imenbenadda/digitalprototypeproject_exsu620/docs/final_rig.jpg

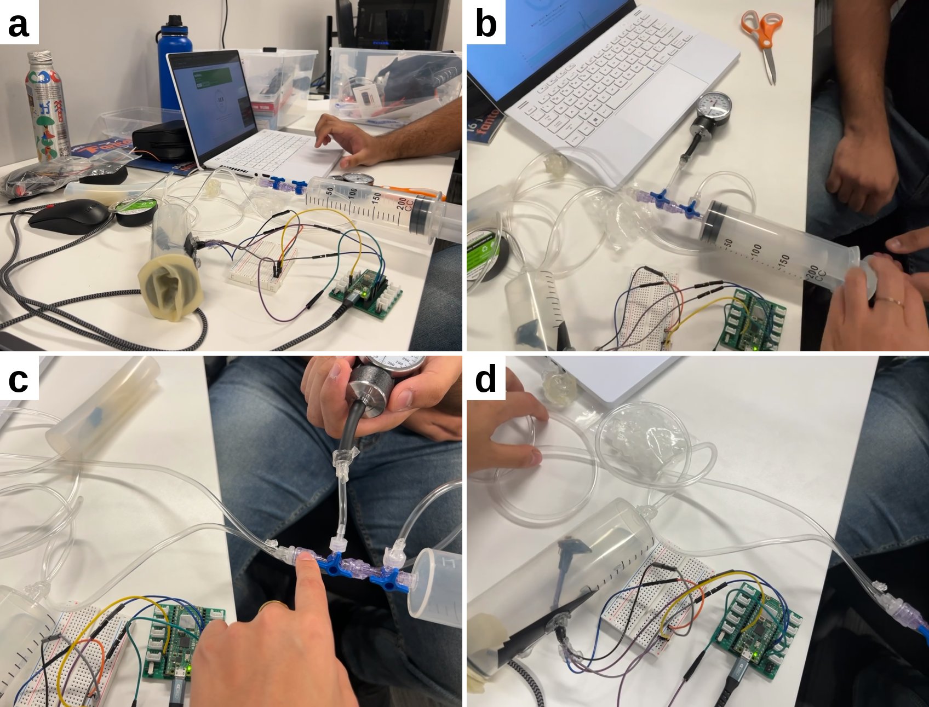
docs/final_rig.jpg
