imenbenadda/digitalprototypeproject_exsu620/docs/dashboard_sms_signup.png

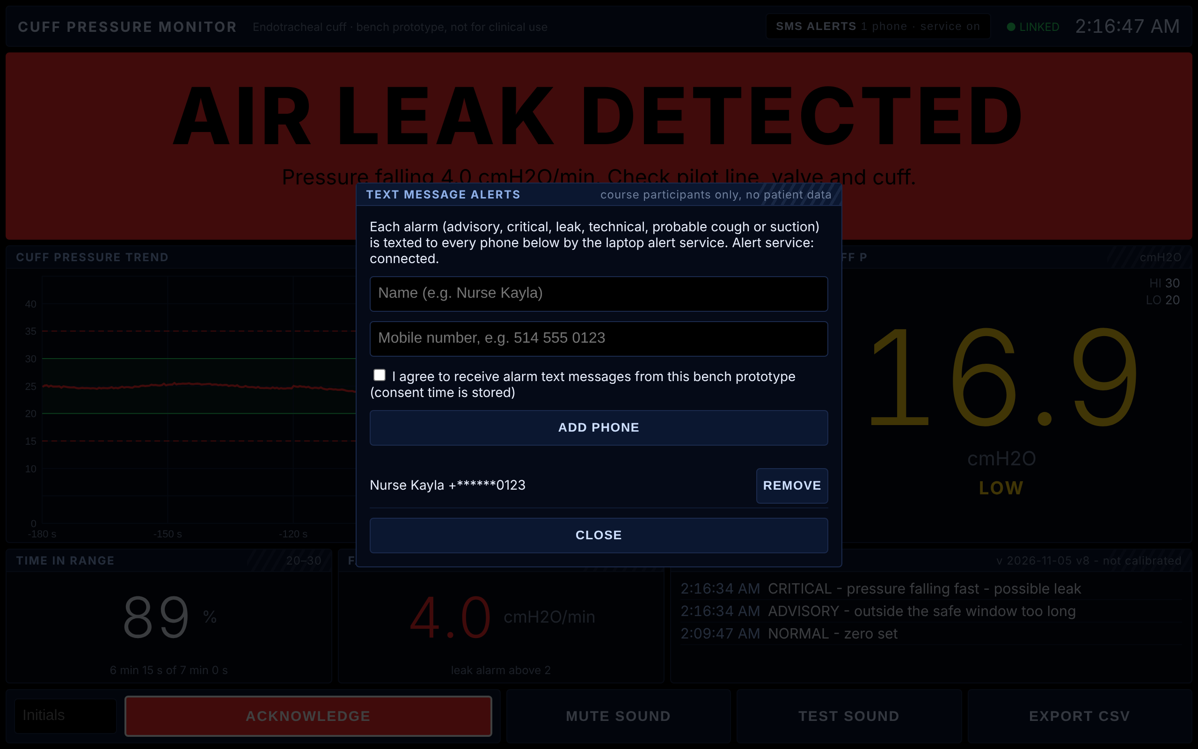
docs/dashboard_sms_signup.png
