imenbenadda/digitalprototypeproject_exsu620/docs/dashboard_states.png

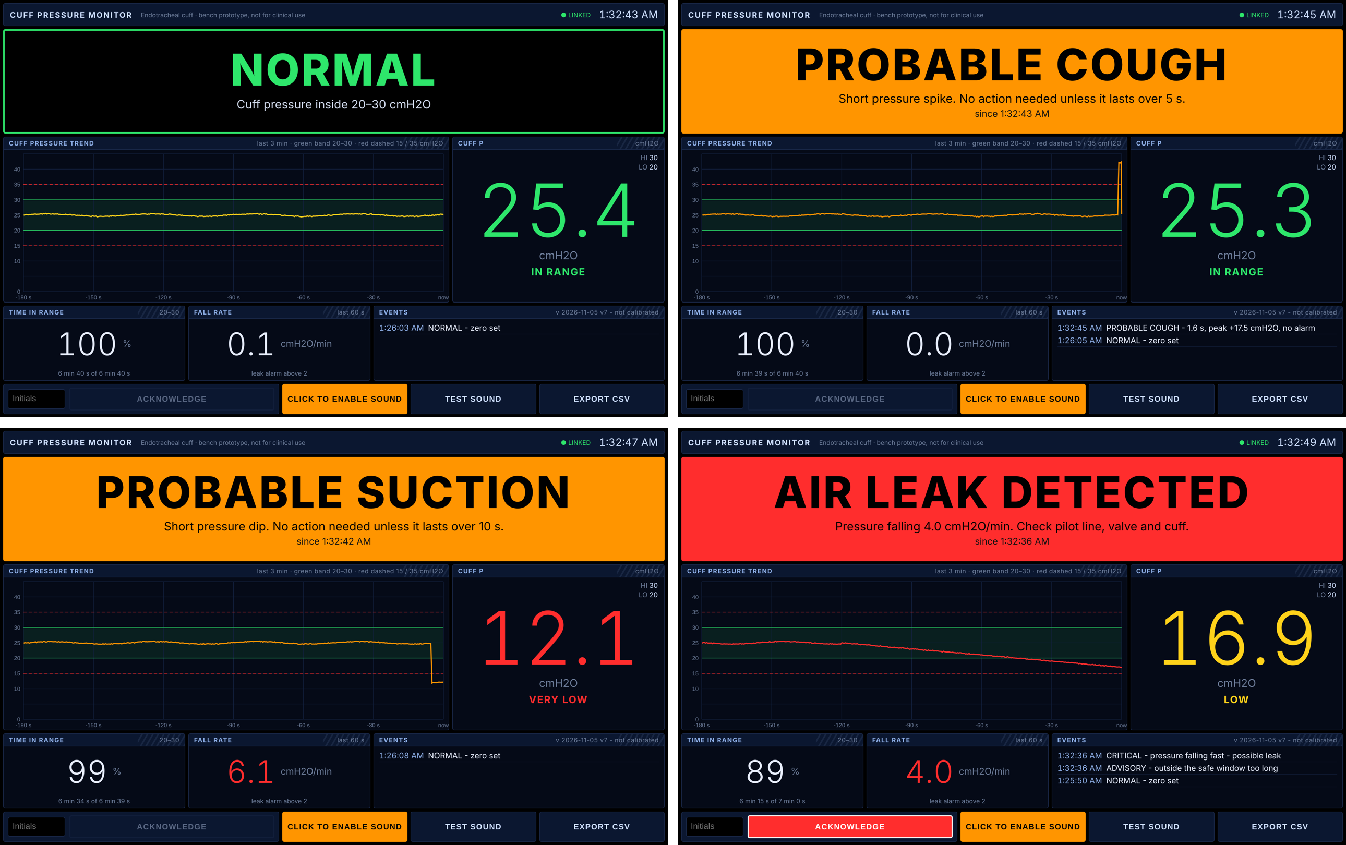
docs/dashboard_states.png
