imenbenadda/digitalprototypeproject_exsu620/cad/cuff_rig_clip.stl

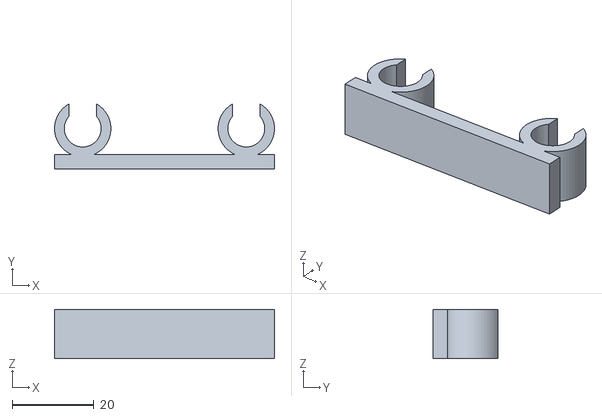
[picture p13: CAD file, 2026-11-05]
cad/cuff_rig_clip.stl
53.8 x 15.9 x 12.0
