imenbenadda/digitalprototypeproject_exsu620/cad/cuff_rig_tray.stl

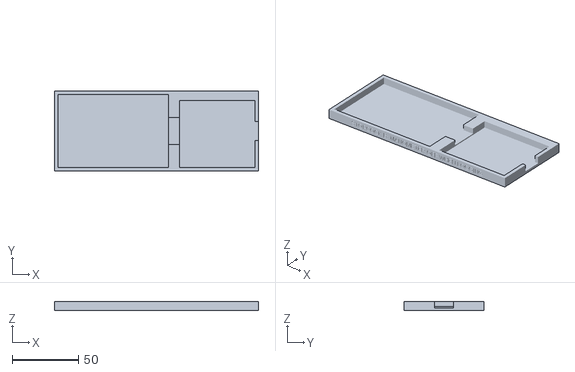
[picture p14: CAD file, 2026-11-05]
cad/cuff_rig_tray.stl
153.5 x 60.5 x 7.00
