imenbenadda/digitalprototypeproject_exsu620/CHANGELOG.md

# Changelog

## 2026-10-22
- Added `cuff_pressure.py`: reads the BMP280 on the Pico 2 W (MicroPython or CircuitPython, no libraries), zeroes to room air, prints cmH2O for Thonny's Plotter with 20/30 cmH2O target lines, warns above 80, saves each trial as CSV on the Pico. Auto-finds the sensor on any Grove I2C port.
- Added `Pico_BMP280_Setup.md`: wiring (Grove shield → BMP280), Thonny/firmware setup, how to run.
- Note: hardware is a Raspberry Pi Pico 2 W on a Grove shield, not a full Raspberry Pi, so the plan's "Pin 1/3/5/6" and "enable I2C" steps don't apply.
- `Pico_BMP280_Setup.md`: wiring table now lists the real wire colors from Imen's photo (VIN black, GND blue, SCK gray, SDI purple). Original kept in `_originals/`.
- `cuff_pressure.py`: added SPI mode so all 6 sensor wires are used, plugged onto the Grove shield's SPI0 header (VIN-3V3, GND-GND, SCK-SCK, SDI-TX, SDO-RX, CS-CS). Auto-detects SPI0 pins, still falls back to Grove I2C. Previous version in `_originals/cuff_pressure_v1_2026-10-22.py`.
- `Pico_BMP280_Setup.md`: wiring section rewritten for the SPI0 header with Imen's real wire colors.
- Not used: direct-to-Pico pin wiring (pins 36/38/6/7/3/9). The Pico sits in the shield, so its pins can't take jumper wires.
- `Pico_BMP280_Setup.md`: wiring table uses pin names only (no wire colors), per Imen.
- Final wiring (4 wires, I2C0): VIN→3V3 OUT, GND→GND, SCK→GP5, SDI→GP4. `cuff_pressure.py` now tries GP4/GP5 first (`OUR_WIRING`), then searches SPI0, every hardware I2C pin pair, and swapped SDA/SCL. Previous version in `_originals/cuff_pressure_v2_2026-10-22.py`. Setup sheet updated to match.
- Correction: the Grove shield does have free GP header holes beside the Pico, so direct GP-pin wiring works.
- `cuff_pressure.py`: added NeoPixel ring (Data In on GP22) and alarm speaker via Mono 2.5W amp (A+ on GP28). Ring: blue below 20 cmH2O, half lit green at 20, more lights fading to orange up to 30, all red flashing above 30. High alarm = fast two-tone; low alarm = slow low beep, armed only after the cuff first reaches 20. No libraries needed (uses built-in neopixel / neopixel_write). Runs fine if ring/speaker aren't wired. Previous version in `_originals/cuff_pressure_v3_2026-10-22.py`.
- `Pico_BMP280_Setup.md`: added section 1b with ring, amp and breadboard connections (pin names only).

## 2026-10-29
- `cuff_pressure.py` stripped down to just the live pressure graph and the NeoPixel ring (CircuitPython only, sensor fixed on GP4/GP5, ring on GP22). Removed: speaker/alarms, CSV saving, SPI and pin auto-search, MicroPython support. Ring now fills up with pressure: white under 20 cmH2O, green from 20 to 30, the rest red over 30 (`ALL_RED_OVER_HIGH = True` turns the whole ring red). Previous version in `_originals/cuff_pressure_v4_2026-10-29.py`.
- `Pico_BMP280_Setup.md`: ring section updated, amplifier removed. Previous version in `_originals/Pico_BMP280_Setup_v3_2026-10-29.md`.
- `cuff_pressure.py`: ring set to 16 lights. Added a startup ring test (all white for 1 s, then each state color), because the previous version turned every light off at zero pressure. The ring now always shows at least one light.
- `cuff_pressure.py`: alarm states from Project Card Figure 3: Normal (green), Advisory (amber, 3 flashes; outside 20–30 for 30 s, clears after 10 s inside), Critical (red, 10 flashes, latched; from Advisory: <15 or >35 for 30 s, or falling >2 cmH2O/min over both the last 60 s and the last 20 s; clears only when acknowledged and back inside 20–30), Technical (cyan blink; sensor error, frozen signal for 10 s, room-air reading for 5 s, or zero not set). Acknowledge: button GP15→GND, or `a` + Enter in the Shell. Pulses/chirp shown as light flashes (no speaker). Ring fills 0–40 cmH2O, colored by state. Tested with a simulated sensor (cough ignored, advisory/normal, critical latch + ack, leak). Previous version in `_originals/cuff_pressure_v5_2026-10-29.py`.
- `Pico_BMP280_Setup.md`: ring/button wiring and state table. Previous version in `_originals/Pico_BMP280_Setup_v4_2026-10-29.md`.
- Ring Data IN moved to GP15 (where Imen wired it), acknowledge button moved to GP14. Previous version in `_originals/cuff_pressure_v6_2026-10-29.py`.
- Added `ring_test.py`: sends white to the ring on GP15 and then every other GP pin, 2 s each, to find where the ring IN wire really is. Main script confirmed running (Thonny log) with the ring on GP15, but the ring stayed dark.
- Ring Data Input moved to GP10 (Imen rewired it): `cuff_pressure.py` ring pin and `ring_test.py` first pin set to GP10. Previous versions in `_originals/`.
- `ring_test.py` rewritten as a bare loop on GP10 (white, red, green, blue, 1 s each) using the built-in `neopixel_write`, because the `neopixel` library is not installed in CIRCUITPY/lib. Previous version in `_originals/ring_test_v2_2026-10-29.py`.
- Installed `neopixel.mpy` (6.4.2) and `adafruit_pixelbuf.mpy` (2.1.0), the CircuitPython 10.x builds from Adafruit's GitHub releases, into CIRCUITPY/lib, so `import neopixel` works.
- Pico `code.py` replaced with the GP10 ring test so it runs by itself without Thonny (original sine-wave `code.py` saved in `_originals/CIRCUITPY_code_py_original.py`). Note: Imen's own `ring_test.py` (saved 16:15) uses GP15 at brightness 0.05; left as is.
- Back to the live graph only: `cuff_pressure.py` now has just the BMP280 (GP4/GP5), zeroing and Plotter output with 20/30 lines. Removed ring, alarm states and button. Pico `code.py` restored to the original. Setup sheet ring section removed. Previous versions in `_originals/` (`cuff_pressure_v8_2026-10-29.py`, `Pico_BMP280_Setup_v5_2026-10-29.md`).

## 2026-11-02
- Added `README.md`: project goal, status, clinical requirements CR-1 to CR-4, Figure 3 alarm states (not in the current code), deliverables and marks, rules, team D5 notes, PVC trachea build, hardware, wiring by pin name, software setup, how to run, what the code does, files, troubleshooting, next steps.

## 2026-11-03
- Installed `adafruit_httpserver` 4.8.2 (CircuitPython 10.x build, from Adafruit's GitHub releases) into CIRCUITPY/lib.
- `cuff_pressure.py`: the Pico now creates its own Wi-Fi network (CuffMonitor, password cuffpressure) and serves a dashboard at http://192.168.4.1 (JSON polling twice a second). Added the Figure 3 alarm states back (same rules as the 29 Oct version): Normal, Advisory, Critical (latched, needs Acknowledge and back in range), Technical. Dashboard: live cmH2O, state banner, 3-minute graph, time inside 20–30, recent events, Acknowledge button with initials, optional beeps (3 / 10 repeating / chirp). Acknowledge also by `a` + Enter in the Shell. Thonny Plotter line unchanged. Waits for the sensor instead of stopping if it isn't found. Tested on the Mac with a simulated sensor; not yet run on the Pico. Previous version in `_originals/cuff_pressure_v9_2026-11-03.py`.
- `README.md`: status, how to open the dashboard, alarm states, troubleshooting. Previous version in `_originals/README_v1_2026-11-03.md`.
- `cuff_pressure.py` dashboard: added the pressure circle in the middle (fills 0–40 cmH2O; red below 15, yellow 15–20, green 20–30, yellow above 30, red after 5 s above 30). The Pico now sends how long pressure has been above 30 (`HIGH_ALERT_DELAY = 5`). Previous version in `_originals/cuff_pressure_v10_2026-11-03.py`.
- `cuff_pressure.py` dashboard sound: replaced the simple beeps with IEC 60601-1-8 style alarm patterns (high priority 10 beeps for Critical, every 5 s until acknowledged; medium priority 3 beeps for Advisory or above 30 for 5 s, every 7 s; low priority 2 beeps for Technical). Sound now turns on with one click anywhere on the page (orange bar until then), plus Test and Mute buttons. Fixes no sound from the Mac speakers.
- `README.md`: circle and sound sections. Previous version in `_originals/README_v2_2026-11-03.md`.
- `cuff_pressure.py` dashboard: Advisory sound now stops as soon as pressure is back inside 20–30 (banner still waits 10 s, with a countdown). Critical is silent once acknowledged, even if still out of range. Banner explains what clears Critical. The Pico sends `in_for` (time back inside). Previous version in `_originals/cuff_pressure_v11_2026-11-03.py`; README in `_originals/README_v3_2026-11-03.md`.
- `cuff_pressure.py` (version 2026-11-03 v5): Acknowledge button always visible in the banner (works only during Critical, per Figure 3), with a note saying when it's needed. Added a 1-row-per-second log on the Pico (last 2 h: time, pressure, state) plus up to 300 events, and an **Export to Excel (.csv)** button (date, time, seconds, cmH2O, state, in range, events and who acknowledged). Version shown in the Shell and at the bottom of the dashboard. Previous version in `_originals/cuff_pressure_v12_2026-11-03.py`; README in `_originals/README_v4_2026-11-03.md`.
- `cuff_pressure.py` (version 2026-11-03 v6): added `CAL_GAIN` / `CAL_OFFSET` calibration settings (shown pressure = gain x sensor + offset); calibration status shown in the Shell and dashboard footer. Previous version in `_originals/cuff_pressure_v13_2026-11-03.py`.
- `README.md`: added "Calibrate against the cuff manometer" and "Find a leak" steps. Previous version in `_originals/README_v5_2026-11-03.md`.

## 2026-11-05
- `cuff_pressure.py` (version 2026-11-05 v7): final design and dashboard revision B.
  - New dashboard: black, monitor style screen that fits one view (no scrolling). One large message: NORMAL (green), PROBABLE COUGH / PROBABLE SUCTION (orange, slow blink, one low tone, never an alarm), LOW / HIGH CUFF PRESSURE (orange, slow blink, medium alarm), AIR LEAK DETECTED / CRITICAL LOW / CRITICAL HIGH (red, fast blink, high alarm until acknowledged), CHECK SENSOR (cyan). Big pressure number with HI/LO limits, 3 min trend, time in range, fall rate, events, and one row of buttons (Acknowledge with initials, sound, test sound, Export CSV). Shows NO SIGNAL FROM MONITOR and beeps if the Pico stops answering.
  - Added `Transient` class: labels a rise of more than 5 cmH2O that ends within 5 s as a probable cough, a drop of more than 5 cmH2O that ends within 10 s as a probable suction. Only when the baseline is at least 15 cmH2O. Logged in the events and the CSV. Alarm states (Figure 3) unchanged.
  - `/data` now also sends `event`, `event_t`, `leak`, `rate` (fall rate, cmH2O/min over 60 s) and `out_for`.
  - Fixed: CSV export lost the event column when the log was longer than 400 rows.
  - Tested in a desktop simulation of the firmware (`tools/sim_cuff_pressure.py`, 6 logic tests pass); not yet run on the Pico. Previous version in `_originals/cuff_pressure_v14_2026-11-05.py`.
- `README.md` rewritten for the final design (two stopcocks, 200 cc syringe, dial manometer) and dashboard revision B. Previous version in `_originals/README_v6_2026-11-05.md`.
- Added `repository/` (GitHub-ready copy: firmware, data, tools, docs, README, CHANGELOG) and `EXSU620_Group2_Design_Dossier.pdf` (rebuilt in the layout of the worked example).
- `cuff_pressure.py` (version 2026-11-05 v8): dashboard **SMS ALERTS** button and form (name, phone, consent); Pico stores up to 5 contacts with consent time (`/register`, `/unregister`, `/contacts`); top bar shows phone count and whether the alert service is connected. Previous version in `_originals/cuff_pressure_v15_2026-11-05.py`.
- Added `service/cuff_service.py`: laptop alert service. SQLite database `cuff.db` (readings, alarm_events, acks, users, notifications), a Twilio text message for every alert to every registered phone (dry run without keys), retries, and a CR-4 shift report. Tested against the simulator: 4 events, 3 texts (dry run).
- Dossier: AI use statement (handbook 6.4), equipment limitation box, ER-1/ER-3 PASS, ER-2 NOT VERIFIED with cause, named sign-offs, interface directions and ranges, database and text alert section (D5), FM-15.
- Added bench run 1 (`data/cuff_log_2026-11-03_1701.csv`) to the repository and dossier: 47 s room air baseline within ±0.04 cmH2O, technical state, and the tubing leak (22.6 to 1.1 cmH2O in 22 s). Dossier: build record photos (Figure 8), two-run trace (Figure 9).

## 2026-11-05
- Dossier: added Figure 1, photos of the final two-stopcock bench rig; later figures renumbered.
- Dossier: zip file citations added beside each supporting file, Appendix A lists the submission zip contents.
- Dossier: options table (dashboard replaces ring/speaker/button, laptop service modified, SMS instead of WhatsApp, OpenSCAD), Figure 2 and module table updated, Figure 6 redrawn with the alert service and phone, IF-11 reordered, new Printed parts section with Figure 10, FMEA FM-12/FM-13 mitigations.
- cad/: OpenSCAD rig tray and stopcock clip with STL files.
