imenbenadda/digitalprototypeproject_exsu620/(commit log)

2026-11-05 Add cuff pressure monitor: firmware v8, alert service, data, dossier
    Firmware v8 (Pico 2 W, CircuitPython 10.3.1) with the monitor-style Wi-Fi
    dashboard and SMS sign-up, laptop alert service (SQLite + Twilio texts +
    shift report), bench data from 3 Nov 2026, desktop simulator, and the
    design dossier PDF.
    Claude-Session: https://claude.ai/code/session_019UvsD2PPTNZ1e1q1wRcEp6
    [cuff_log_2026-11-03_1703.csv]
2026-11-05 Add bench run 1 data and update dossier
    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
    [cuff_log_2026-11-03_1701.csv]
2026-11-05 Add printed parts, fix dossier contradictions
    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
    [cuff_rig_clip.stl, cuff_rig_parts.scad, cuff_rig_tray.stl]
